garethcheyne/cecilia-hardware/case/renders/unit-back.png

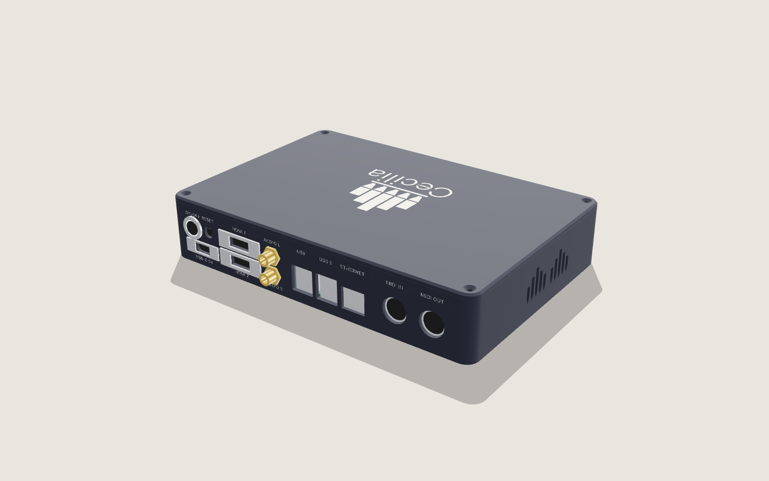
case/renders/unit-back.png
