garethcheyne/cecilia-hardware/case/renders/unit-open-back.png

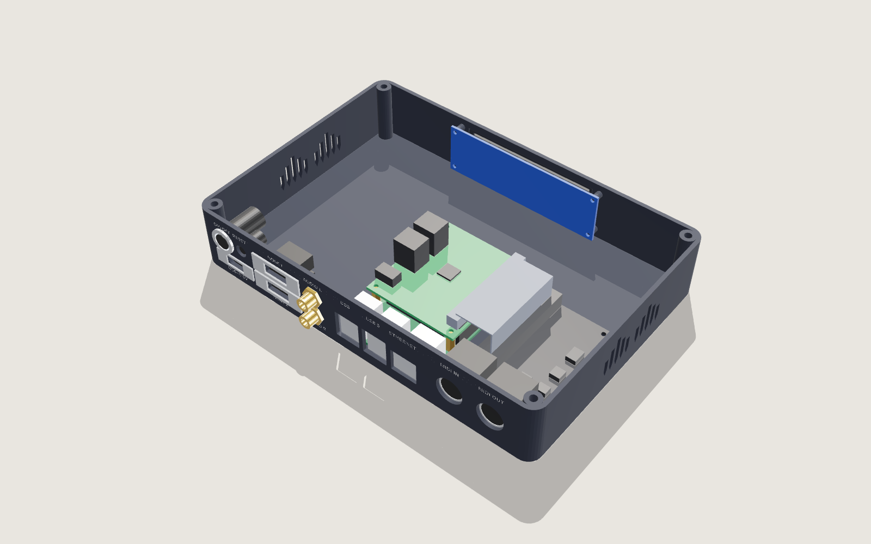
case/renders/unit-open-back.png
