garethcheyne/cecilia-hardware/case/renders/unit-open.png

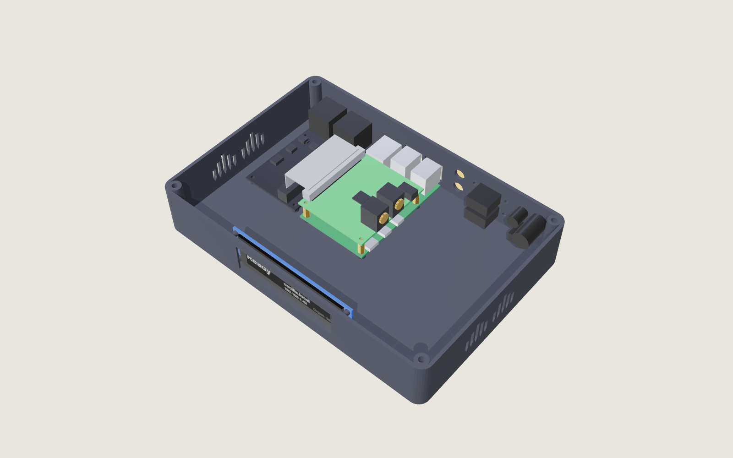
case/renders/unit-open.png
