garethcheyne/cecilia-hardware/docs/COST.md

# What a Cecilia unit costs

Estimates in **US dollars**, before tax, shipping and import duty, as of
November 2026. Raspberry Pi prices have risen sharply through 2026 because
memory is scarce: check current prices before ordering. Prices for the
display, cables and printing are typical online prices, not quotes.

## One unit (prototypes, 2–5 made)

| Part | US$ | Notes |
| --- | ---: | --- |
| Raspberry Pi 5, 4 GB | 110 | List price after the April 2026 rise. The 2 GB model is US$77.50 |
| Raspberry Pi 27 W USB-C supply | 12 | |
| Raspberry Pi Active Cooler | 6 | |
| microSD card, 32 GB | 10 | |
| 3.12-inch 256 × 64 OLED | 20 | US$15–35 depending on the maker |
| Panel-mount cables: 2 × HDMI, 1 × USB-C | 25 | |
| Buttons, ribbon, JST leads | 10 | |
| Screws, inserts, feet, smoked window | 8 | |
| Cecilia I/O board, assembled | 30 | Five boards from PCBWay come to roughly US$100–180 with shipping |
| Case, printed (MJF nylon, dyed black) | 80 | US$60–120: about 250 cm³ of nylon |
| **Total** | **≈ 310** | Roughly US$280–360 |
| *Optional:* Raspberry Pi DAC+ | 20 | |
| *Optional:* phono couplers and leads | 8 | Only with the DAC+ |

The Pi with its supply, cooler and card comes to **about US$140, nearly half
the cost.**

## In small batches (about 50)

| | US$ each |
| --- | ---: |
| Pi 5, supply, cooler, card | 130 |
| Display, cables, buttons, hardware | 45 |
| I/O board, assembled | 10 |
| Case, printed | 60 |
| **Total** | **≈ 245** |

Printed cases don't get much cheaper in quantity. Moulded ones do.

## In larger batches (about 500, moulded case)

| | US$ each |
| --- | ---: |
| Pi 5, supply, cooler, card | 125 |
| Display, cables, buttons, hardware | 35 |
| I/O board, assembled | 6 |
| Case, injection moulded (PC/ABS) | 8 |
| Mould tooling, spread over 500 cases | 20–30 |
| **Total** | **≈ 195–205** |

## One-off costs

| | US$ | Notes |
| --- | ---: | --- |
| First I/O boards from PCBWay | 100–180 | Five boards, assembled, with shipping |
| First printed cases | 150–250 | Two sets, to check the fit |
| Schematic and board layout | 0–3 000 | Free if a volunteer does it; a contractor for a simple 2-layer board |
| EMC testing (RCM, and CE/FCC if sold there) | 2 000–6 000 | A test lab's quote is the real figure; a pre-scan first saves money |
| Injection-mould tooling | 8 000–15 000 | Only for the moulded case: two simple parts |

## Ways to bring it down

- **Pi 5 2 GB** saves about US$32. That suits a unit without touch screens;
  two screens running the console want 4 GB.
- **Kits:** sell the I/O board, display and case, and let the church buy the
  Pi locally. That cuts the price and stock risk, and it changes the
  certification paperwork (see [SPEC.md](SPEC.md#certification)).
- **Skip the display** on a basic model: about US$25 less, and the unit still
  shows its address on the screens at the console.
