garethcheyne/cecilia-hardware/case/out/case-lid.stl

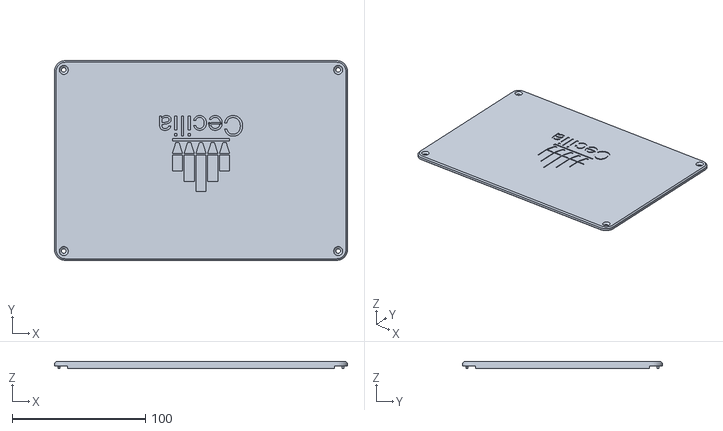
[picture p12: CAD file, 2026-11-11]
case/out/case-lid.stl
220.0 x 150.0 x 5.20
