garethcheyne/cecilia-hardware/case/out/parts/io-din-rings.stl

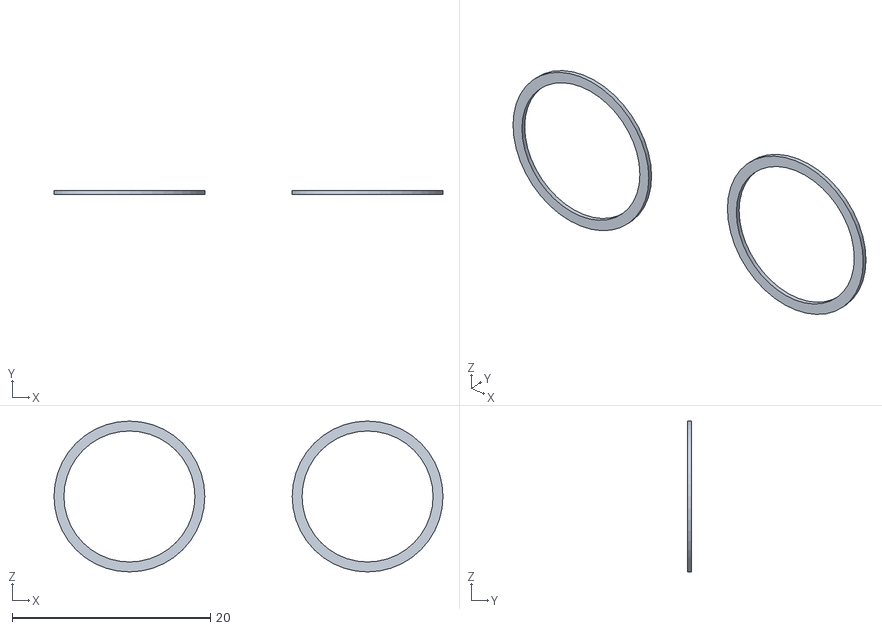
[picture p13: CAD file, 2026-11-11]
case/out/parts/io-din-rings.stl
39.2 x 0.4 x 15.2
