garethcheyne/cecilia-hardware/case/out/case-base.stl

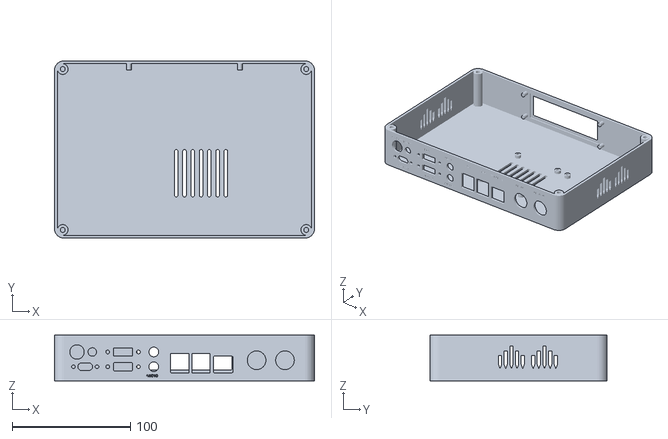
[picture p14: CAD file, 2026-11-11]
case/out/case-base.stl
220.0 x 150.0 x 38.8
