garethcheyne/cecilia-hardware/case/out/parts/pi-chips.stl

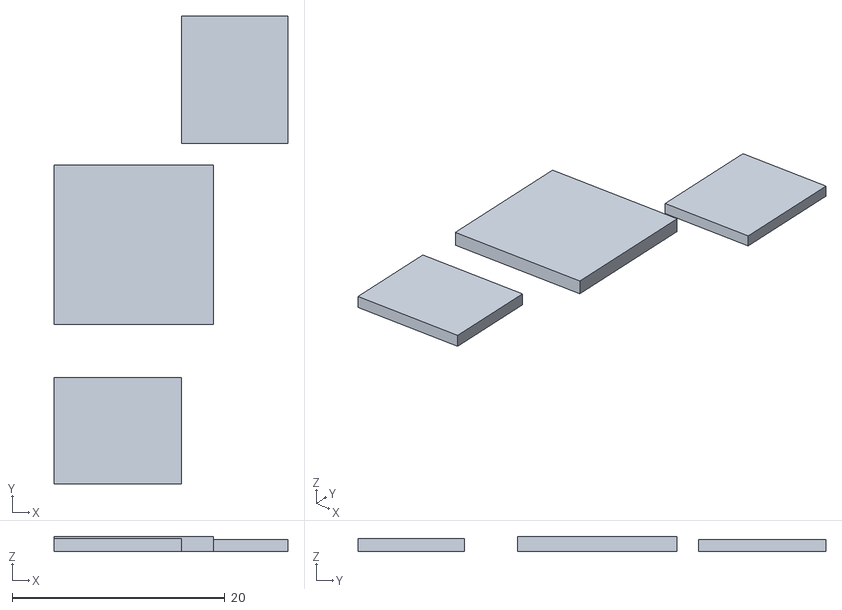
[picture p15: CAD file, 2026-11-11]
case/out/parts/pi-chips.stl
22.0 x 44.0 x 1.40
