garethcheyne/cecilia-hardware/case/out/case-labels.stl

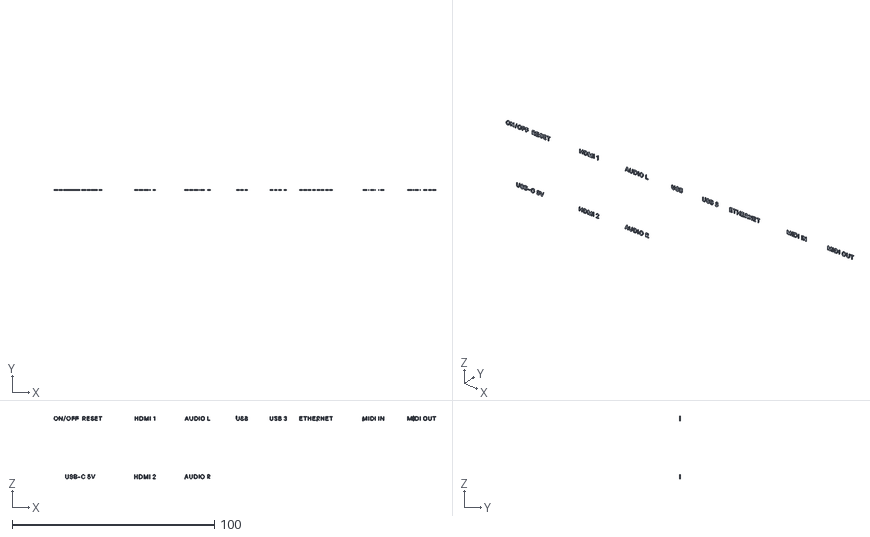
[picture p16: CAD file, 2026-11-11]
case/out/case-labels.stl
189.0 x 0.45 x 31.0
