garethcheyne/cecilia-hardware/case/out/parts/panel-metal.stl

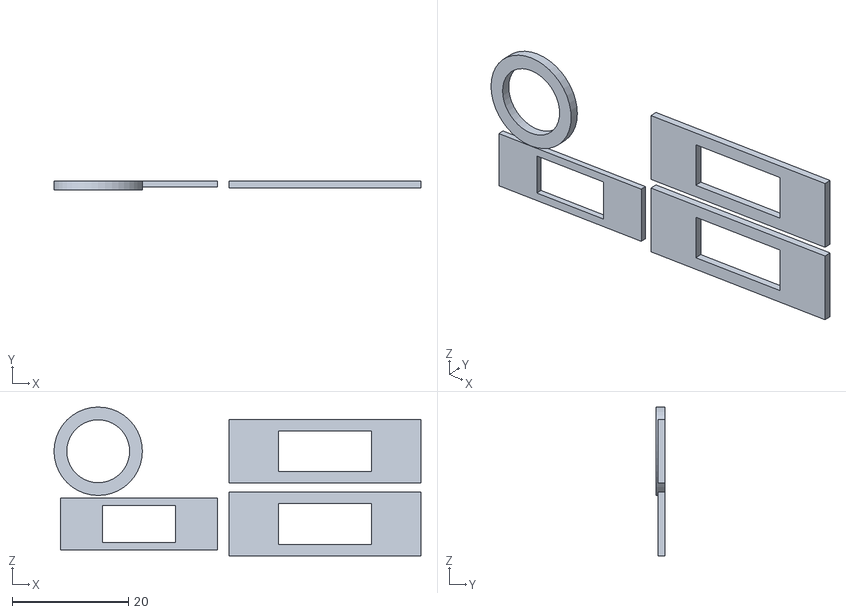
[picture p17: CAD file, 2026-11-11]
case/out/parts/panel-metal.stl
63.1 x 1.50 x 25.6
