garethcheyne/cecilia-hardware/case/out/case-engraving.stl

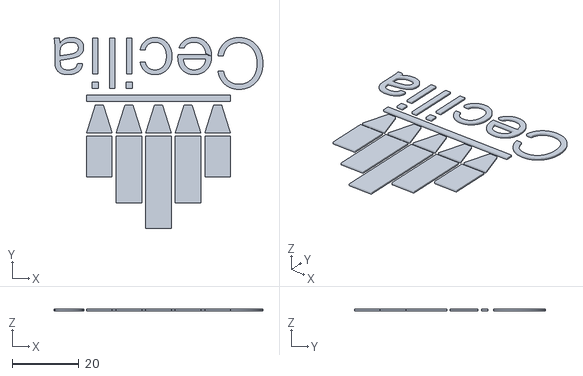
[picture p18: CAD file, 2026-11-11]
case/out/case-engraving.stl
62.5 x 57.2 x 0.58
