garethcheyne/cecilia-hardware/case/out/parts/ribbon.stl

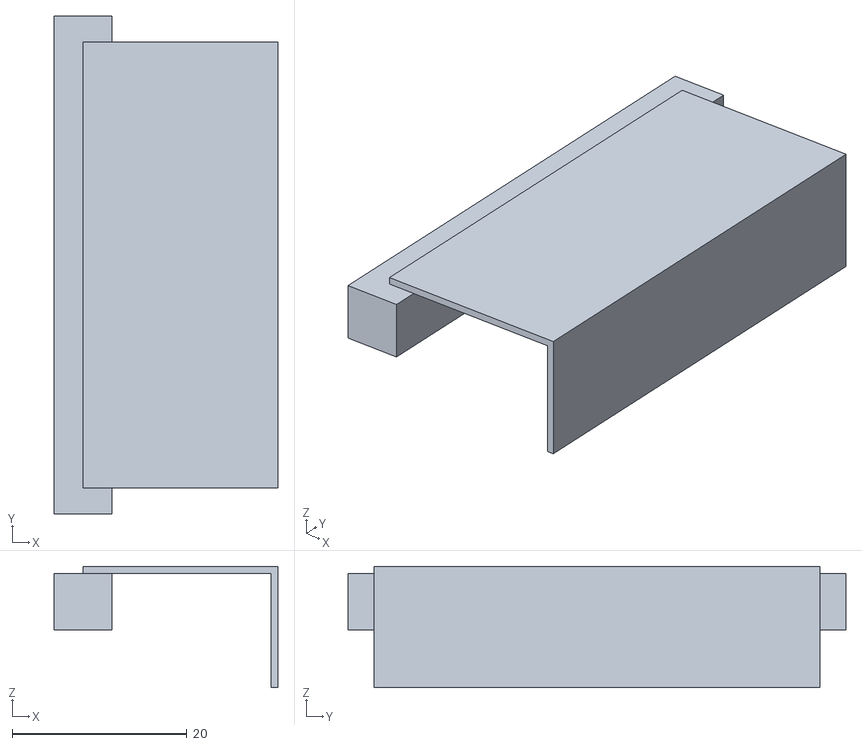
[picture p19: CAD file, 2026-11-11]
case/out/parts/ribbon.stl
25.6 x 57.0 x 13.9
