garethcheyne/cecilia-hardware/case/out/case-window.stl

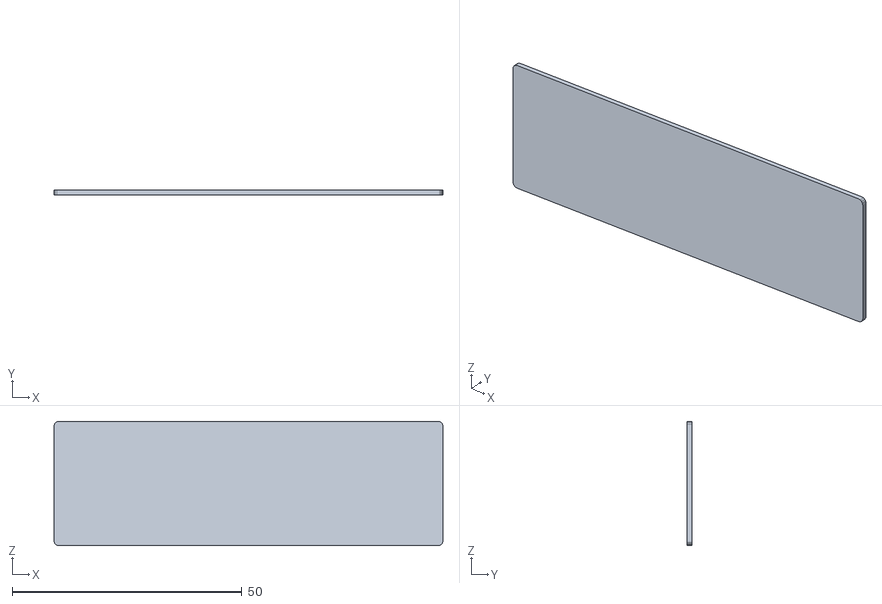
[picture p20: CAD file, 2026-11-11]
case/out/case-window.stl
84.6 x 1 x 27.0
