garethcheyne/cecilia-hardware/case/out/parts/dac-gold.stl

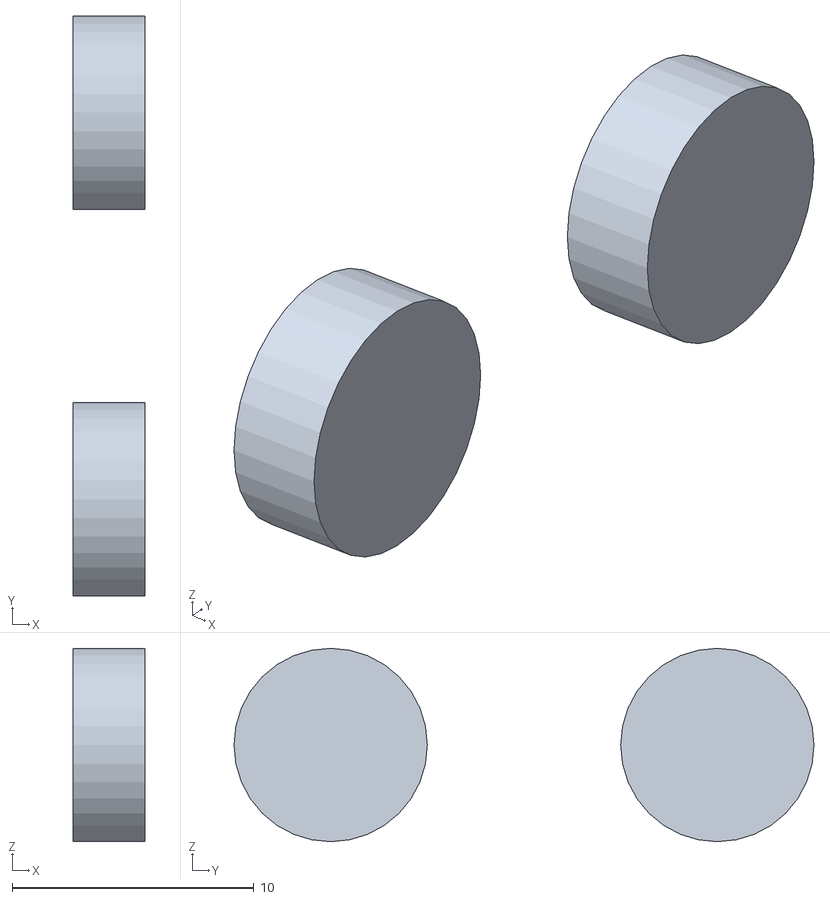
[picture p21: CAD file, 2026-11-11]
case/out/parts/dac-gold.stl
3.00 x 24.0 x 8.00
