garethcheyne/cecilia-hardware/case/out/parts/pi-metal.stl

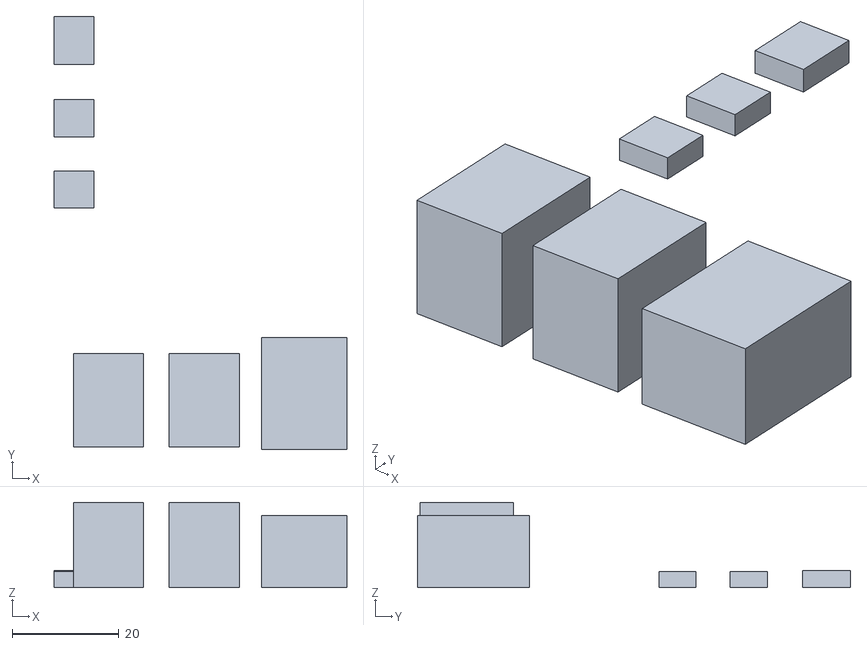
[picture p22: CAD file, 2026-11-11]
case/out/parts/pi-metal.stl
55.0 x 81.3 x 16.0
