garethcheyne/cecilia-hardware/case/out/parts/dac-standoffs.stl

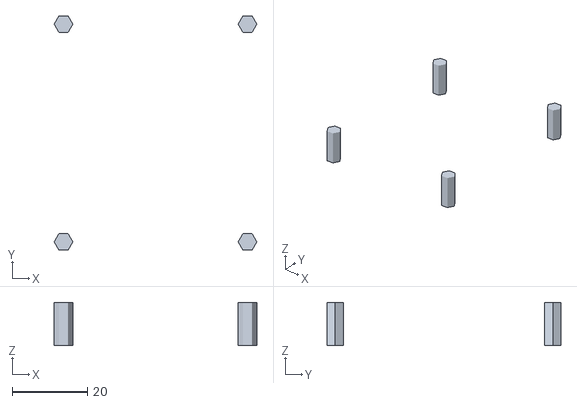
[picture p23: CAD file, 2026-11-11]
case/out/parts/dac-standoffs.stl
54.0 x 62.3 x 11.5
