garethcheyne/cecilia-hardware/case/out/parts/panel-gold.stl

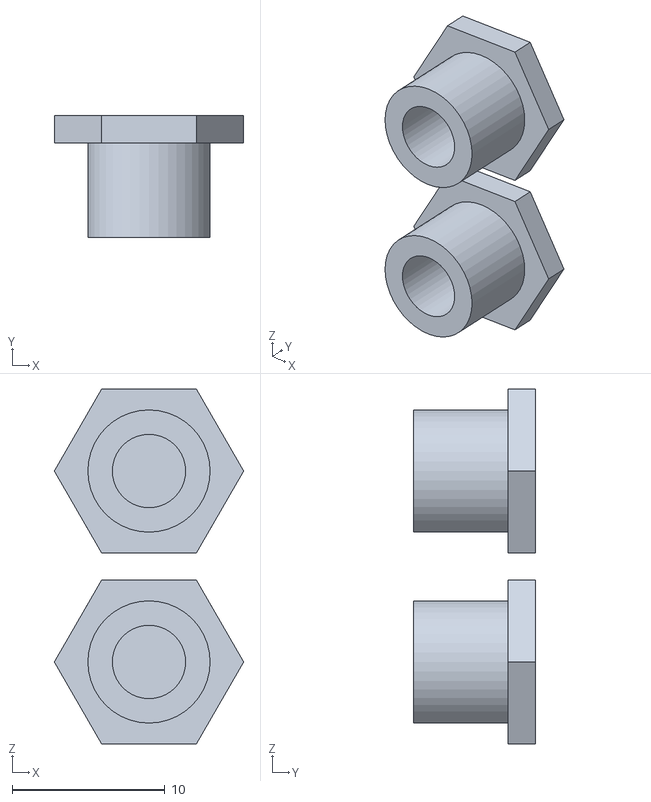
[picture p24: CAD file, 2026-11-11]
case/out/parts/panel-gold.stl
12.4 x 8.00 x 23.2
