garethcheyne/cecilia-hardware/case/out/parts/oled-pcb.stl

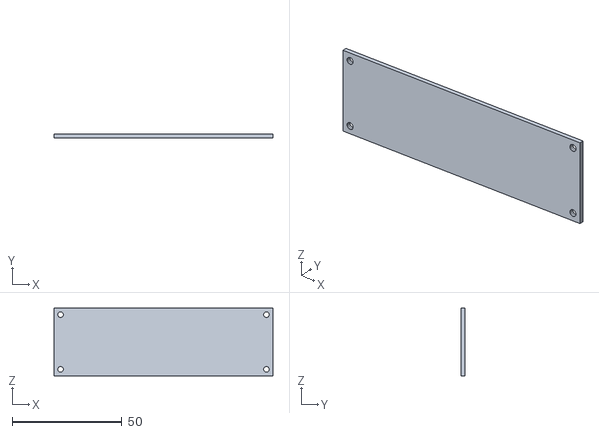
[picture p25: CAD file, 2026-11-11]
case/out/parts/oled-pcb.stl
100.0 x 1.60 x 31.0
