garethcheyne/cecilia-hardware/case/out/parts/pi-header.stl

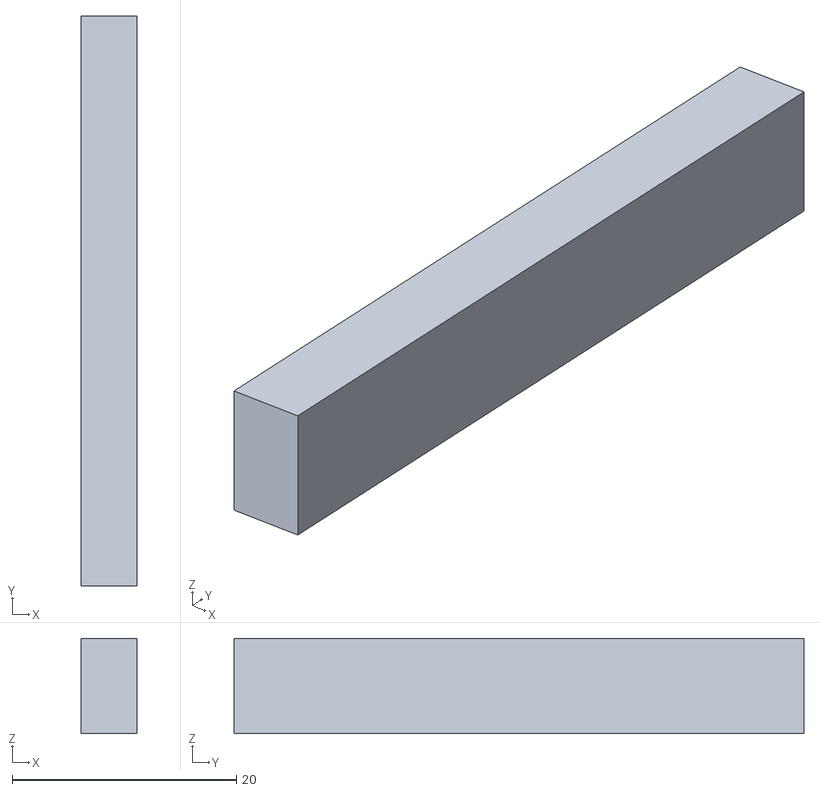
[picture p26: CAD file, 2026-11-11]
case/out/parts/pi-header.stl
5.00 x 50.8 x 8.50
