garethcheyne/cecilia-hardware/case/out/parts/pi-board.stl

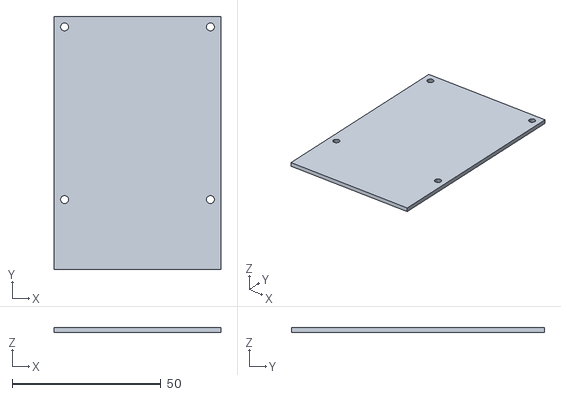
[picture p27: CAD file, 2026-11-11]
case/out/parts/pi-board.stl
56.0 x 85.0 x 1.60
