garethcheyne/cecilia-hardware/case/out/parts/onoff-ring.stl

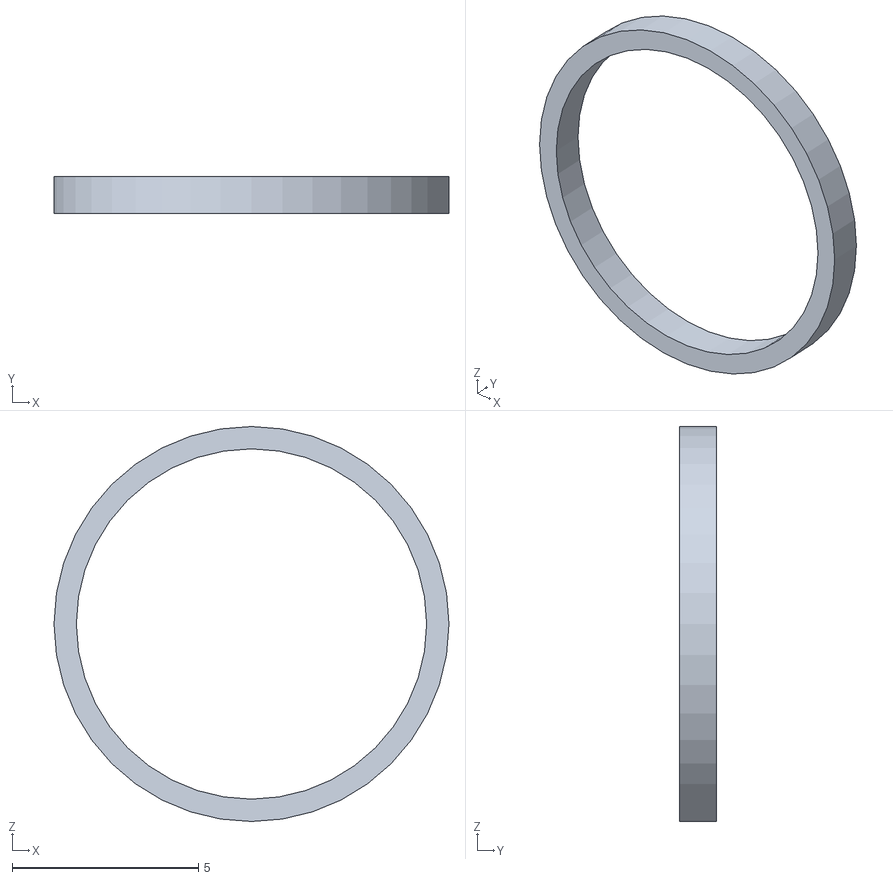
[picture p28: CAD file, 2026-11-11]
case/out/parts/onoff-ring.stl
10.6 x 1 x 10.6
