garethcheyne/cecilia-hardware/case/out/parts/cooler.stl

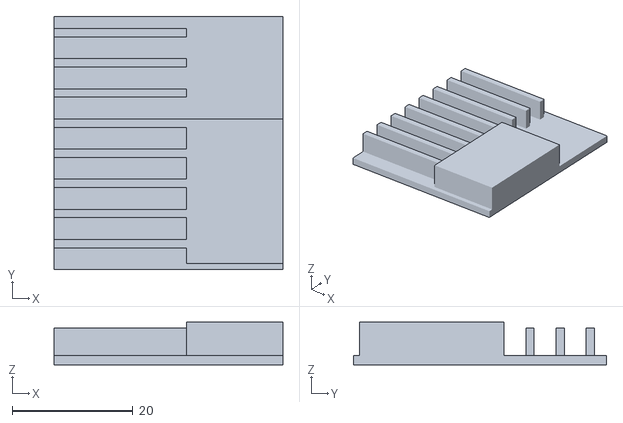
[picture p29: CAD file, 2026-11-11]
case/out/parts/cooler.stl
38.0 x 42.0 x 7.10
