garethcheyne/cecilia-hardware/case/out/parts/io-board.stl

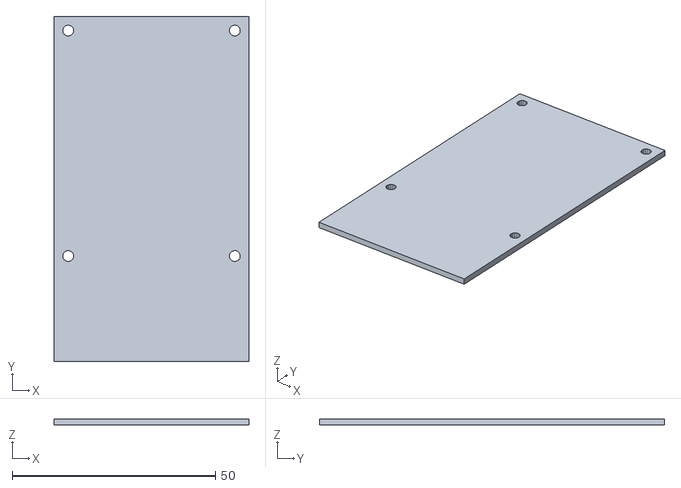
[picture p30: CAD file, 2026-11-11]
case/out/parts/io-board.stl
48.0 x 85.0 x 1.60
