garethcheyne/cecilia-hardware/case/out/parts/io-parts.stl

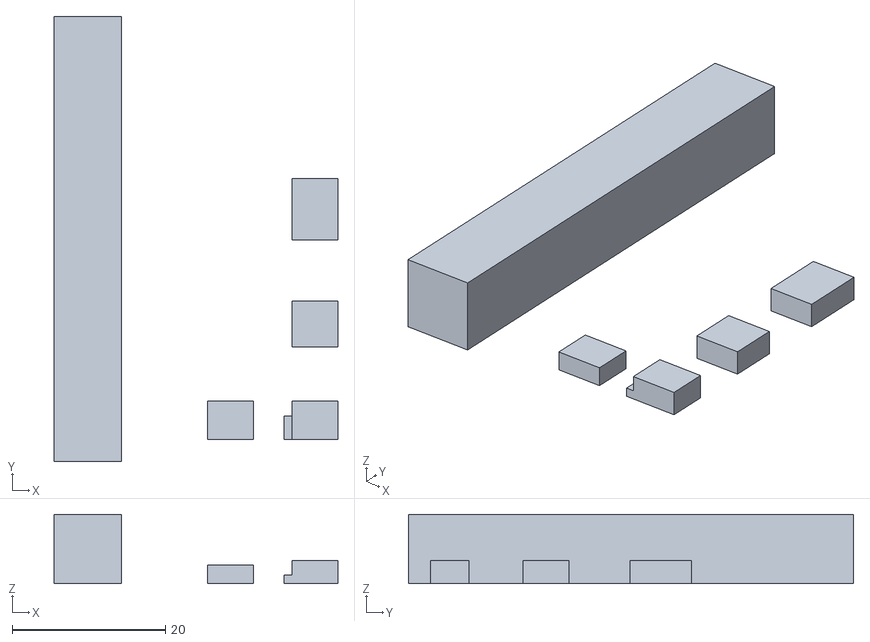
[picture p31: CAD file, 2026-11-11]
case/out/parts/io-parts.stl
37.0 x 58.0 x 9.00
