garethcheyne/cecilia-hardware/case/out/parts/dac-board.stl

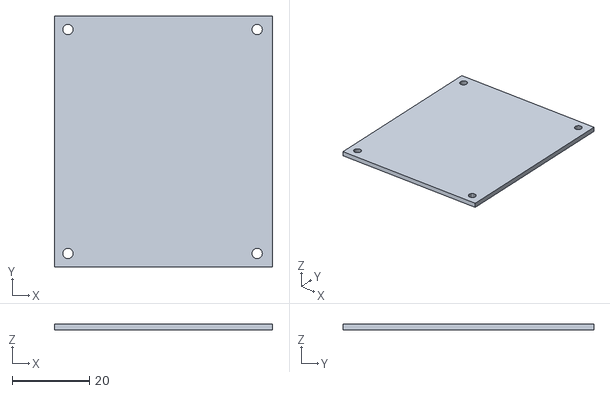
[picture p32: CAD file, 2026-11-11]
case/out/parts/dac-board.stl
56.5 x 65.0 x 1.60
