garethcheyne/cecilia-hardware/case/out/parts/io-din.stl

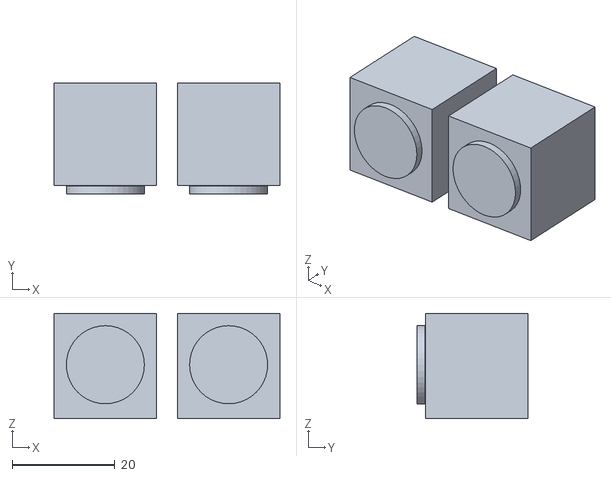
[picture p33: CAD file, 2026-11-11]
case/out/parts/io-din.stl
44.0 x 21.7 x 20.5
