garethcheyne/cecilia-hardware/case/out/parts/panel-dark.stl

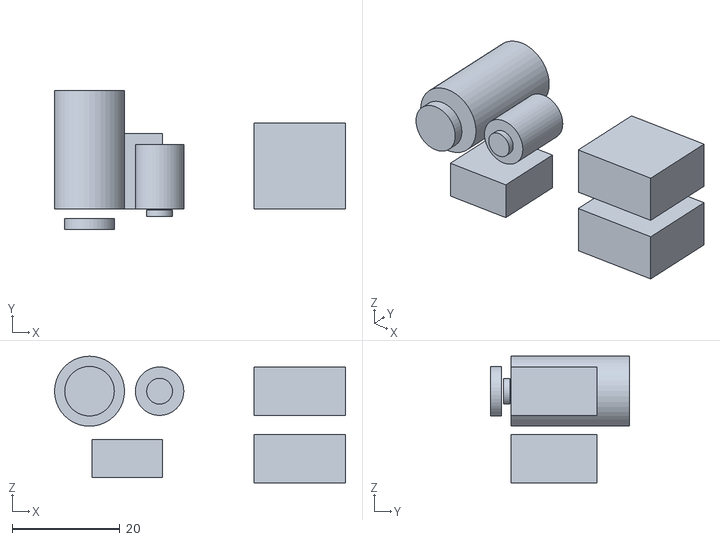
[picture p34: CAD file, 2026-11-11]
case/out/parts/panel-dark.stl
54.0 x 25.8 x 23.5
