garethcheyne/cecilia-hardware/case/out/parts/oled-glass.stl

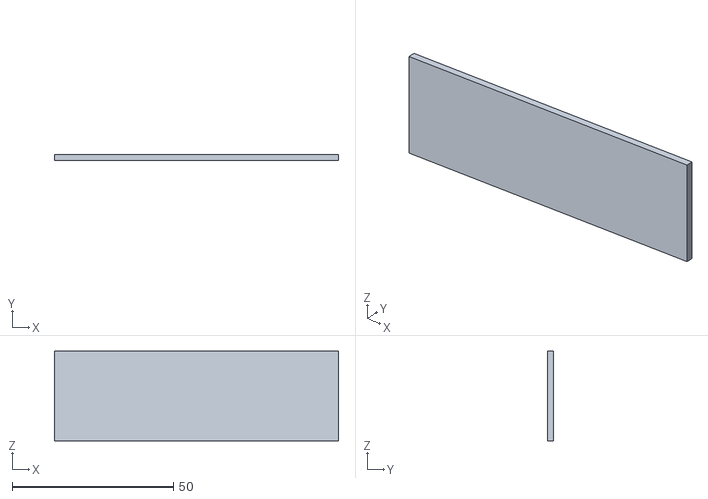
[picture p35: CAD file, 2026-11-11]
case/out/parts/oled-glass.stl
88.0 x 2.00 x 27.8
