garethcheyne/cecilia-hardware/case/out/parts/dac-parts.stl

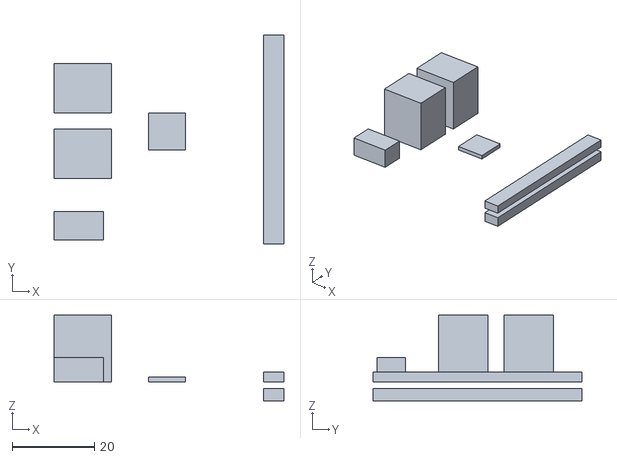
[picture p36: CAD file, 2026-11-11]
case/out/parts/dac-parts.stl
56.0 x 50.8 x 20.9
