garethcheyne/cecilia-hardware/(commit log)

2026-11-11 Cecilia unit: CM5 carrier board specification, PCBWay build list and order notes, and the case as code with renders
    [carrier-bom.csv, case-base.stl, case-engraving.stl, case-lid.stl, off-board.csv]
2026-11-11 Pi 5 + Cecilia HAT: repairable unit in a plastic case
    Redesigned around a standard Raspberry Pi 5 (keeps its own approvals; any
    Pi 5 swaps in) and a 2-layer HAT+ board: MIDI IN/OUT, line out, status
    OLED, ON/OFF and RESET. Clean front (mark, status light, screen); every
    socket on the back. Case parts, internal models, renders, spec, BOMs and
    the PCBWay order updated; the CM5 carrier moves to docs/future.
    [button-board.stl, button.stl, case-base.stl, case-engraving.stl, case-labels.stl, case-lid.stl, case-window.stl, cm5-carrier-bom.csv]
2026-11-11 Flat box with everything on the back, room for a DAC+, and a cost estimate
    220 x 150 x 42 mm. The Pi 5's USB and Ethernet come straight through the
    back; panel-mount cables bring power and full-size HDMI there too. Four USB
    (organ, two touch screens, spare). A Cecilia I/O board (MIDI) on a ribbon
    keeps the GPIO header free for an optional Raspberry Pi DAC+, whose phono
    outputs reach AUDIO L/R couplers. Only a 3.12in 256x64 OLED on the front.
    ON/OFF with a lit ring and RESET on the back. docs/COST.md estimates
    prototype, batch and volume costs.
    [button-board.stl, button.stl, case-base.stl, case-engraving.stl, case-labels.stl, case-lid.stl, case-window.stl, cooler.stl]
